fjpolo/SR-1_SoC/PremadePrograms/HandAssembled/README.txt

These files are old - I am writing an assembler to do the hard work for me.
It is very tedious to write programs by hand, so I do not recommend it!!
