fjpolo/SR-1_SoC/Testing/README.txt

Relevant files for testing purposes (placeholder for the Gowin IP cores, as I could not get their sim package to work)
