fjpolo/SR-1_SoC/GPU/VRAM/gowin_dpb/dp_bsram16v.v

//Copyright (C)2014-2024 Gowin Semiconductor Corporation.
//All rights reserved.
//File Title: IP file
//Tool Version: V1.9.10.03 Education (64-bit)
//Part Number: GW1NR-LV9QN88PC6/I5
//Device: GW1NR-9
//Device Version: C
//Created Time: Tue Feb 11 19:09:59 2025

module DP_BSRAM16V (douta, doutb, clka, ocea, cea, reseta, wrea, clkb, oceb, ceb, resetb, wreb, ada, dina, adb, dinb);

output [15:0] douta;
output [15:0] doutb;
input clka;
input ocea;
input cea;
input reseta;
input wrea;
input clkb;
input oceb;
input ceb;
input resetb;
input wreb;
input [12:0] ada;
input [15:0] dina;
input [12:0] adb;
input [15:0] dinb;

wire [11:0] dpb_inst_0_douta_w;
wire [3:0] dpb_inst_0_douta;
wire [11:0] dpb_inst_0_doutb_w;
wire [3:0] dpb_inst_0_doutb;
wire [11:0] dpb_inst_1_douta_w;
wire [7:4] dpb_inst_1_douta;
wire [11:0] dpb_inst_1_doutb_w;
wire [7:4] dpb_inst_1_doutb;
wire [7:0] dpb_inst_2_douta_w;
wire [7:0] dpb_inst_2_douta;
wire [7:0] dpb_inst_2_doutb_w;
wire [7:0] dpb_inst_2_doutb;
wire [11:0] dpb_inst_3_douta_w;
wire [11:8] dpb_inst_3_douta;
wire [11:0] dpb_inst_3_doutb_w;
wire [11:8] dpb_inst_3_doutb;
wire [11:0] dpb_inst_4_douta_w;
wire [15:12] dpb_inst_4_douta;
wire [11:0] dpb_inst_4_doutb_w;
wire [15:12] dpb_inst_4_doutb;
wire [7:0] dpb_inst_5_douta_w;
wire [15:8] dpb_inst_5_douta;
wire [7:0] dpb_inst_5_doutb_w;
wire [15:8] dpb_inst_5_doutb;
wire dff_q_0;
wire dff_q_1;
wire cea_w;
wire ceb_w;
wire gw_gnd;

assign cea_w = ~wrea & cea;
assign ceb_w = ~wreb & ceb;
assign gw_gnd = 1'b0;

DPB dpb_inst_0 (
    .DOA({dpb_inst_0_douta_w[11:0],dpb_inst_0_douta[3:0]}),
    .DOB({dpb_inst_0_doutb_w[11:0],dpb_inst_0_doutb[3:0]}),
    .CLKA(clka),
    .OCEA(ocea),
    .CEA(cea),
    .RESETA(reseta),
    .WREA(wrea),
    .CLKB(clkb),
    .OCEB(oceb),
    .CEB(ceb),
    .RESETB(resetb),
    .WREB(wreb),
    .BLKSELA({gw_gnd,gw_gnd,ada[12]}),
    .BLKSELB({gw_gnd,gw_gnd,adb[12]}),
    .ADA({ada[11:0],gw_gnd,gw_gnd}),
    .DIA({gw_gnd,gw_gnd,gw_gnd,gw_gnd,gw_gnd,gw_gnd,gw_gnd,gw_gnd,gw_gnd,gw_gnd,gw_gnd,gw_gnd,dina[3:0]}),
    .ADB({adb[11:0],gw_gnd,gw_gnd}),
    .DIB({gw_gnd,gw_gnd,gw_gnd,gw_gnd,gw_gnd,gw_gnd,gw_gnd,gw_gnd,gw_gnd,gw_gnd,gw_gnd,gw_gnd,dinb[3:0]})
);

defparam dpb_inst_0.READ_MODE0 = 1'b0;
defparam dpb_inst_0.READ_MODE1 = 1'b0;
defparam dpb_inst_0.WRITE_MODE0 = 2'b00;
defparam dpb_inst_0.WRITE_MODE1 = 2'b00;
defparam dpb_inst_0.BIT_WIDTH_0 = 4;
defparam dpb_inst_0.BIT_WIDTH_1 = 4;
defparam dpb_inst_0.BLK_SEL_0 = 3'b000;
defparam dpb_inst_0.BLK_SEL_1 = 3'b000;
defparam dpb_inst_0.RESET_MODE = "ASYNC";

DPB dpb_inst_1 (
    .DOA({dpb_inst_1_douta_w[11:0],dpb_inst_1_douta[7:4]}),
    .DOB({dpb_inst_1_doutb_w[11:0],dpb_inst_1_doutb[7:4]}),
    .CLKA(clka),
    .OCEA(ocea),
    .CEA(cea),
    .RESETA(reseta),
    .WREA(wrea),
    .CLKB(clkb),
    .OCEB(oceb),
    .CEB(ceb),
    .RESETB(resetb),
    .WREB(wreb),
    .BLKSELA({gw_gnd,gw_gnd,ada[12]}),
    .BLKSELB({gw_gnd,gw_gnd,adb[12]}),
    .ADA({ada[11:0],gw_gnd,gw_gnd}),
    .DIA({gw_gnd,gw_gnd,gw_gnd,gw_gnd,gw_gnd,gw_gnd,gw_gnd,gw_gnd,gw_gnd,gw_gnd,gw_gnd,gw_gnd,dina[7:4]}),
    .ADB({adb[11:0],gw_gnd,gw_gnd}),
    .DIB({gw_gnd,gw_gnd,gw_gnd,gw_gnd,gw_gnd,gw_gnd,gw_gnd,gw_gnd,gw_gnd,gw_gnd,gw_gnd,gw_gnd,dinb[7:4]})
);

defparam dpb_inst_1.READ_MODE0 = 1'b0;
defparam dpb_inst_1.READ_MODE1 = 1'b0;
defparam dpb_inst_1.WRITE_MODE0 = 2'b00;
defparam dpb_inst_1.WRITE_MODE1 = 2'b00;
defparam dpb_inst_1.BIT_WIDTH_0 = 4;
defparam dpb_inst_1.BIT_WIDTH_1 = 4;
defparam dpb_inst_1.BLK_SEL_0 = 3'b000;
defparam dpb_inst_1.BLK_SEL_1 = 3'b000;
defparam dpb_inst_1.RESET_MODE = "ASYNC";

DPB dpb_inst_2 (
    .DOA({dpb_inst_2_douta_w[7:0],dpb_inst_2_douta[7:0]}),
    .DOB({dpb_inst_2_doutb_w[7:0],dpb_inst_2_doutb[7:0]}),
    .CLKA(clka),
    .OCEA(ocea),
    .CEA(cea),
    .RESETA(reseta),
    .WREA(wrea),
    .CLKB(clkb),
    .OCEB(oceb),
    .CEB(ceb),
    .RESETB(resetb),
    .WREB(wreb),
    .BLKSELA({gw_gnd,ada[12],ada[11]}),
    .BLKSELB({gw_gnd,adb[12],adb[11]}),
    .ADA({ada[10:0],gw_gnd,gw_gnd,gw_gnd}),
    .DIA({gw_gnd,gw_gnd,gw_gnd,gw_gnd,gw_gnd,gw_gnd,gw_gnd,gw_gnd,dina[7:0]}),
    .ADB({adb[10:0],gw_gnd,gw_gnd,gw_gnd}),
    .DIB({gw_gnd,gw_gnd,gw_gnd,gw_gnd,gw_gnd,gw_gnd,gw_gnd,gw_gnd,dinb[7:0]})
);

defparam dpb_inst_2.READ_MODE0 = 1'b0;
defparam dpb_inst_2.READ_MODE1 = 1'b0;
defparam dpb_inst_2.WRITE_MODE0 = 2'b00;
defparam dpb_inst_2.WRITE_MODE1 = 2'b00;
defparam dpb_inst_2.BIT_WIDTH_0 = 8;
defparam dpb_inst_2.BIT_WIDTH_1 = 8;
defparam dpb_inst_2.BLK_SEL_0 = 3'b010;
defparam dpb_inst_2.BLK_SEL_1 = 3'b010;
defparam dpb_inst_2.RESET_MODE = "ASYNC";

DPB dpb_inst_3 (
    .DOA({dpb_inst_3_douta_w[11:0],dpb_inst_3_douta[11:8]}),
    .DOB({dpb_inst_3_doutb_w[11:0],dpb_inst_3_doutb[11:8]}),
    .CLKA(clka),
    .OCEA(ocea),
    .CEA(cea),
    .RESETA(reseta),
    .WREA(wrea),
    .CLKB(clkb),
    .OCEB(oceb),
    .CEB(ceb),
    .RESETB(resetb),
    .WREB(wreb),
    .BLKSELA({gw_gnd,gw_gnd,ada[12]}),
    .BLKSELB({gw_gnd,gw_gnd,adb[12]}),
    .ADA({ada[11:0],gw_gnd,gw_gnd}),
    .DIA({gw_gnd,gw_gnd,gw_gnd,gw_gnd,gw_gnd,gw_gnd,gw_gnd,gw_gnd,gw_gnd,gw_gnd,gw_gnd,gw_gnd,dina[11:8]}),
    .ADB({adb[11:0],gw_gnd,gw_gnd}),
    .DIB({gw_gnd,gw_gnd,gw_gnd,gw_gnd,gw_gnd,gw_gnd,gw_gnd,gw_gnd,gw_gnd,gw_gnd,gw_gnd,gw_gnd,dinb[11:8]})
);

defparam dpb_inst_3.READ_MODE0 = 1'b0;
defparam dpb_inst_3.READ_MODE1 = 1'b0;
defparam dpb_inst_3.WRITE_MODE0 = 2'b00;
defparam dpb_inst_3.WRITE_MODE1 = 2'b00;
defparam dpb_inst_3.BIT_WIDTH_0 = 4;
defparam dpb_inst_3.BIT_WIDTH_1 = 4;
defparam dpb_inst_3.BLK_SEL_0 = 3'b000;
defparam dpb_inst_3.BLK_SEL_1 = 3'b000;
defparam dpb_inst_3.RESET_MODE = "ASYNC";

DPB dpb_inst_4 (
    .DOA({dpb_inst_4_douta_w[11:0],dpb_inst_4_douta[15:12]}),
    .DOB({dpb_inst_4_doutb_w[11:0],dpb_inst_4_doutb[15:12]}),
    .CLKA(clka),
    .OCEA(ocea),
    .CEA(cea),
    .RESETA(reseta),
    .WREA(wrea),
    .CLKB(clkb),
    .OCEB(oceb),
    .CEB(ceb),
    .RESETB(resetb),
    .WREB(wreb),
    .BLKSELA({gw_gnd,gw_gnd,ada[12]}),
    .BLKSELB({gw_gnd,gw_gnd,adb[12]}),
    .ADA({ada[11:0],gw_gnd,gw_gnd}),
    .DIA({gw_gnd,gw_gnd,gw_gnd,gw_gnd,gw_gnd,gw_gnd,gw_gnd,gw_gnd,gw_gnd,gw_gnd,gw_gnd,gw_gnd,dina[15:12]}),
    .ADB({adb[11:0],gw_gnd,gw_gnd}),
    .DIB({gw_gnd,gw_gnd,gw_gnd,gw_gnd,gw_gnd,gw_gnd,gw_gnd,gw_gnd,gw_gnd,gw_gnd,gw_gnd,gw_gnd,dinb[15:12]})
);

defparam dpb_inst_4.READ_MODE0 = 1'b0;
defparam dpb_inst_4.READ_MODE1 = 1'b0;
defparam dpb_inst_4.WRITE_MODE0 = 2'b00;
defparam dpb_inst_4.WRITE_MODE1 = 2'b00;
defparam dpb_inst_4.BIT_WIDTH_0 = 4;
defparam dpb_inst_4.BIT_WIDTH_1 = 4;
defparam dpb_inst_4.BLK_SEL_0 = 3'b000;
defparam dpb_inst_4.BLK_SEL_1 = 3'b000;
defparam dpb_inst_4.RESET_MODE = "ASYNC";

DPB dpb_inst_5 (
    .DOA({dpb_inst_5_douta_w[7:0],dpb_inst_5_douta[15:8]}),
    .DOB({dpb_inst_5_doutb_w[7:0],dpb_inst_5_doutb[15:8]}),
    .CLKA(clka),
    .OCEA(ocea),
    .CEA(cea),
    .RESETA(reseta),
    .WREA(wrea),
    .CLKB(clkb),
    .OCEB(oceb),
    .CEB(ceb),
    .RESETB(resetb),
    .WREB(wreb),
    .BLKSELA({gw_gnd,ada[12],ada[11]}),
    .BLKSELB({gw_gnd,adb[12],adb[11]}),
    .ADA({ada[10:0],gw_gnd,gw_gnd,gw_gnd}),
    .DIA({gw_gnd,gw_gnd,gw_gnd,gw_gnd,gw_gnd,gw_gnd,gw_gnd,gw_gnd,dina[15:8]}),
    .ADB({adb[10:0],gw_gnd,gw_gnd,gw_gnd}),
    .DIB({gw_gnd,gw_gnd,gw_gnd,gw_gnd,gw_gnd,gw_gnd,gw_gnd,gw_gnd,dinb[15:8]})
);

defparam dpb_inst_5.READ_MODE0 = 1'b0;
defparam dpb_inst_5.READ_MODE1 = 1'b0;
defparam dpb_inst_5.WRITE_MODE0 = 2'b00;
defparam dpb_inst_5.WRITE_MODE1 = 2'b00;
defparam dpb_inst_5.BIT_WIDTH_0 = 8;
defparam dpb_inst_5.BIT_WIDTH_1 = 8;
defparam dpb_inst_5.BLK_SEL_0 = 3'b010;
defparam dpb_inst_5.BLK_SEL_1 = 3'b010;
defparam dpb_inst_5.RESET_MODE = "ASYNC";

DFFE dff_inst_0 (
  .Q(dff_q_0),
  .D(ada[12]),
  .CLK(clka),
  .CE(cea_w)
);
DFFE dff_inst_1 (
  .Q(dff_q_1),
  .D(adb[12]),
  .CLK(clkb),
  .CE(ceb_w)
);
MUX2 mux_inst_2 (
  .O(douta[0]),
  .I0(dpb_inst_0_douta[0]),
  .I1(dpb_inst_2_douta[0]),
  .S0(dff_q_0)
);
MUX2 mux_inst_5 (
  .O(douta[1]),
  .I0(dpb_inst_0_douta[1]),
  .I1(dpb_inst_2_douta[1]),
  .S0(dff_q_0)
);
MUX2 mux_inst_8 (
  .O(douta[2]),
  .I0(dpb_inst_0_douta[2]),
  .I1(dpb_inst_2_douta[2]),
  .S0(dff_q_0)
);
MUX2 mux_inst_11 (
  .O(douta[3]),
  .I0(dpb_inst_0_douta[3]),
  .I1(dpb_inst_2_douta[3]),
  .S0(dff_q_0)
);
MUX2 mux_inst_14 (
  .O(douta[4]),
  .I0(dpb_inst_1_douta[4]),
  .I1(dpb_inst_2_douta[4]),
  .S0(dff_q_0)
);
MUX2 mux_inst_17 (
  .O(douta[5]),
  .I0(dpb_inst_1_douta[5]),
  .I1(dpb_inst_2_douta[5]),
  .S0(dff_q_0)
);
MUX2 mux_inst_20 (
  .O(douta[6]),
  .I0(dpb_inst_1_douta[6]),
  .I1(dpb_inst_2_douta[6]),
  .S0(dff_q_0)
);
MUX2 mux_inst_23 (
  .O(douta[7]),
  .I0(dpb_inst_1_douta[7]),
  .I1(dpb_inst_2_douta[7]),
  .S0(dff_q_0)
);
MUX2 mux_inst_26 (
  .O(douta[8]),
  .I0(dpb_inst_3_douta[8]),
  .I1(dpb_inst_5_douta[8]),
  .S0(dff_q_0)
);
MUX2 mux_inst_29 (
  .O(douta[9]),
  .I0(dpb_inst_3_douta[9]),
  .I1(dpb_inst_5_douta[9]),
  .S0(dff_q_0)
);
MUX2 mux_inst_32 (
  .O(douta[10]),
  .I0(dpb_inst_3_douta[10]),
  .I1(dpb_inst_5_douta[10]),
  .S0(dff_q_0)
);
MUX2 mux_inst_35 (
  .O(douta[11]),
  .I0(dpb_inst_3_douta[11]),
  .I1(dpb_inst_5_douta[11]),
  .S0(dff_q_0)
);
MUX2 mux_inst_38 (
  .O(douta[12]),
  .I0(dpb_inst_4_douta[12]),
  .I1(dpb_inst_5_douta[12]),
  .S0(dff_q_0)
);
MUX2 mux_inst_41 (
  .O(douta[13]),
  .I0(dpb_inst_4_douta[13]),
  .I1(dpb_inst_5_douta[13]),
  .S0(dff_q_0)
);
MUX2 mux_inst_44 (
  .O(douta[14]),
  .I0(dpb_inst_4_douta[14]),
  .I1(dpb_inst_5_douta[14]),
  .S0(dff_q_0)
);
MUX2 mux_inst_47 (
  .O(douta[15]),
  .I0(dpb_inst_4_douta[15]),
  .I1(dpb_inst_5_douta[15]),
  .S0(dff_q_0)
);
MUX2 mux_inst_50 (
  .O(doutb[0]),
  .I0(dpb_inst_0_doutb[0]),
  .I1(dpb_inst_2_doutb[0]),
  .S0(dff_q_1)
);
MUX2 mux_inst_53 (
  .O(doutb[1]),
  .I0(dpb_inst_0_doutb[1]),
  .I1(dpb_inst_2_doutb[1]),
  .S0(dff_q_1)
);
MUX2 mux_inst_56 (
  .O(doutb[2]),
  .I0(dpb_inst_0_doutb[2]),
  .I1(dpb_inst_2_doutb[2]),
  .S0(dff_q_1)
);
MUX2 mux_inst_59 (
  .O(doutb[3]),
  .I0(dpb_inst_0_doutb[3]),
  .I1(dpb_inst_2_doutb[3]),
  .S0(dff_q_1)
);
MUX2 mux_inst_62 (
  .O(doutb[4]),
  .I0(dpb_inst_1_doutb[4]),
  .I1(dpb_inst_2_doutb[4]),
  .S0(dff_q_1)
);
MUX2 mux_inst_65 (
  .O(doutb[5]),
  .I0(dpb_inst_1_doutb[5]),
  .I1(dpb_inst_2_doutb[5]),
  .S0(dff_q_1)
);
MUX2 mux_inst_68 (
  .O(doutb[6]),
  .I0(dpb_inst_1_doutb[6]),
  .I1(dpb_inst_2_doutb[6]),
  .S0(dff_q_1)
);
MUX2 mux_inst_71 (
  .O(doutb[7]),
  .I0(dpb_inst_1_doutb[7]),
  .I1(dpb_inst_2_doutb[7]),
  .S0(dff_q_1)
);
MUX2 mux_inst_74 (
  .O(doutb[8]),
  .I0(dpb_inst_3_doutb[8]),
  .I1(dpb_inst_5_doutb[8]),
  .S0(dff_q_1)
);
MUX2 mux_inst_77 (
  .O(doutb[9]),
  .I0(dpb_inst_3_doutb[9]),
  .I1(dpb_inst_5_doutb[9]),
  .S0(dff_q_1)
);
MUX2 mux_inst_80 (
  .O(doutb[10]),
  .I0(dpb_inst_3_doutb[10]),
  .I1(dpb_inst_5_doutb[10]),
  .S0(dff_q_1)
);
MUX2 mux_inst_83 (
  .O(doutb[11]),
  .I0(dpb_inst_3_doutb[11]),
  .I1(dpb_inst_5_doutb[11]),
  .S0(dff_q_1)
);
MUX2 mux_inst_86 (
  .O(doutb[12]),
  .I0(dpb_inst_4_doutb[12]),
  .I1(dpb_inst_5_doutb[12]),
  .S0(dff_q_1)
);
MUX2 mux_inst_89 (
  .O(doutb[13]),
  .I0(dpb_inst_4_doutb[13]),
  .I1(dpb_inst_5_doutb[13]),
  .S0(dff_q_1)
);
MUX2 mux_inst_92 (
  .O(doutb[14]),
  .I0(dpb_inst_4_doutb[14]),
  .I1(dpb_inst_5_doutb[14]),
  .S0(dff_q_1)
);
MUX2 mux_inst_95 (
  .O(doutb[15]),
  .I0(dpb_inst_4_doutb[15]),
  .I1(dpb_inst_5_doutb[15]),
  .S0(dff_q_1)
);
endmodule //DP_BSRAM16V
