fjpolo/SR-1_SoC/CPU/Memory/v1/gowin_sp/bsram.v

//Copyright (C)2014-2024 Gowin Semiconductor Corporation.
//All rights reserved.
//File Title: IP file
//Tool Version: V1.9.10.03 Education (64-bit)
//Part Number: GW1NR-LV9QN88PC6/I5
//Device: GW1NR-9
//Device Version: C
//Created Time: Tue Jan 21 01:02:18 2025

module BSRAM (dout, clk, oce, ce, reset, wre, ad, din);

output [7:0] dout;
input clk;
input oce;
input ce;
input reset;
input wre;
input [14:0] ad;
input [7:0] din;

wire [30:0] sp_inst_0_dout_w;
wire [0:0] sp_inst_0_dout;
wire [30:0] sp_inst_1_dout_w;
wire [0:0] sp_inst_1_dout;
wire [30:0] sp_inst_2_dout_w;
wire [1:1] sp_inst_2_dout;
wire [30:0] sp_inst_3_dout_w;
wire [1:1] sp_inst_3_dout;
wire [30:0] sp_inst_4_dout_w;
wire [2:2] sp_inst_4_dout;
wire [30:0] sp_inst_5_dout_w;
wire [2:2] sp_inst_5_dout;
wire [30:0] sp_inst_6_dout_w;
wire [3:3] sp_inst_6_dout;
wire [30:0] sp_inst_7_dout_w;
wire [3:3] sp_inst_7_dout;
wire [30:0] sp_inst_8_dout_w;
wire [4:4] sp_inst_8_dout;
wire [30:0] sp_inst_9_dout_w;
wire [4:4] sp_inst_9_dout;
wire [30:0] sp_inst_10_dout_w;
wire [5:5] sp_inst_10_dout;
wire [30:0] sp_inst_11_dout_w;
wire [5:5] sp_inst_11_dout;
wire [30:0] sp_inst_12_dout_w;
wire [6:6] sp_inst_12_dout;
wire [30:0] sp_inst_13_dout_w;
wire [6:6] sp_inst_13_dout;
wire [30:0] sp_inst_14_dout_w;
wire [7:7] sp_inst_14_dout;
wire [30:0] sp_inst_15_dout_w;
wire [7:7] sp_inst_15_dout;
wire dff_q_0;
wire ce_w;
wire gw_gnd;

assign ce_w = ~wre & ce;
assign gw_gnd = 1'b0;

SP sp_inst_0 (
    .DO({sp_inst_0_dout_w[30:0],sp_inst_0_dout[0]}),
    .CLK(clk),
    .OCE(oce),
    .CE(ce),
    .RESET(reset),
    .WRE(wre),
    .BLKSEL({gw_gnd,gw_gnd,ad[14]}),
    .AD(ad[13:0]),
    .DI({gw_gnd,gw_gnd,gw_gnd,gw_gnd,gw_gnd,gw_gnd,gw_gnd,gw_gnd,gw_gnd,gw_gnd,gw_gnd,gw_gnd,gw_gnd,gw_gnd,gw_gnd,gw_gnd,gw_gnd,gw_gnd,gw_gnd,gw_gnd,gw_gnd,gw_gnd,gw_gnd,gw_gnd,gw_gnd,gw_gnd,gw_gnd,gw_gnd,gw_gnd,gw_gnd,gw_gnd,din[0]})
);

defparam sp_inst_0.READ_MODE = 1'b0;
defparam sp_inst_0.WRITE_MODE = 2'b00;
defparam sp_inst_0.BIT_WIDTH = 1;
defparam sp_inst_0.BLK_SEL = 3'b000;
defparam sp_inst_0.RESET_MODE = "ASYNC";

SP sp_inst_1 (
    .DO({sp_inst_1_dout_w[30:0],sp_inst_1_dout[0]}),
    .CLK(clk),
    .OCE(oce),
    .CE(ce),
    .RESET(reset),
    .WRE(wre),
    .BLKSEL({gw_gnd,gw_gnd,ad[14]}),
    .AD(ad[13:0]),
    .DI({gw_gnd,gw_gnd,gw_gnd,gw_gnd,gw_gnd,gw_gnd,gw_gnd,gw_gnd,gw_gnd,gw_gnd,gw_gnd,gw_gnd,gw_gnd,gw_gnd,gw_gnd,gw_gnd,gw_gnd,gw_gnd,gw_gnd,gw_gnd,gw_gnd,gw_gnd,gw_gnd,gw_gnd,gw_gnd,gw_gnd,gw_gnd,gw_gnd,gw_gnd,gw_gnd,gw_gnd,din[0]})
);

defparam sp_inst_1.READ_MODE = 1'b0;
defparam sp_inst_1.WRITE_MODE = 2'b00;
defparam sp_inst_1.BIT_WIDTH = 1;
defparam sp_inst_1.BLK_SEL = 3'b001;
defparam sp_inst_1.RESET_MODE = "ASYNC";

SP sp_inst_2 (
    .DO({sp_inst_2_dout_w[30:0],sp_inst_2_dout[1]}),
    .CLK(clk),
    .OCE(oce),
    .CE(ce),
    .RESET(reset),
    .WRE(wre),
    .BLKSEL({gw_gnd,gw_gnd,ad[14]}),
    .AD(ad[13:0]),
    .DI({gw_gnd,gw_gnd,gw_gnd,gw_gnd,gw_gnd,gw_gnd,gw_gnd,gw_gnd,gw_gnd,gw_gnd,gw_gnd,gw_gnd,gw_gnd,gw_gnd,gw_gnd,gw_gnd,gw_gnd,gw_gnd,gw_gnd,gw_gnd,gw_gnd,gw_gnd,gw_gnd,gw_gnd,gw_gnd,gw_gnd,gw_gnd,gw_gnd,gw_gnd,gw_gnd,gw_gnd,din[1]})
);

defparam sp_inst_2.READ_MODE = 1'b0;
defparam sp_inst_2.WRITE_MODE = 2'b00;
defparam sp_inst_2.BIT_WIDTH = 1;
defparam sp_inst_2.BLK_SEL = 3'b000;
defparam sp_inst_2.RESET_MODE = "ASYNC";

SP sp_inst_3 (
    .DO({sp_inst_3_dout_w[30:0],sp_inst_3_dout[1]}),
    .CLK(clk),
    .OCE(oce),
    .CE(ce),
    .RESET(reset),
    .WRE(wre),
    .BLKSEL({gw_gnd,gw_gnd,ad[14]}),
    .AD(ad[13:0]),
    .DI({gw_gnd,gw_gnd,gw_gnd,gw_gnd,gw_gnd,gw_gnd,gw_gnd,gw_gnd,gw_gnd,gw_gnd,gw_gnd,gw_gnd,gw_gnd,gw_gnd,gw_gnd,gw_gnd,gw_gnd,gw_gnd,gw_gnd,gw_gnd,gw_gnd,gw_gnd,gw_gnd,gw_gnd,gw_gnd,gw_gnd,gw_gnd,gw_gnd,gw_gnd,gw_gnd,gw_gnd,din[1]})
);

defparam sp_inst_3.READ_MODE = 1'b0;
defparam sp_inst_3.WRITE_MODE = 2'b00;
defparam sp_inst_3.BIT_WIDTH = 1;
defparam sp_inst_3.BLK_SEL = 3'b001;
defparam sp_inst_3.RESET_MODE = "ASYNC";

SP sp_inst_4 (
    .DO({sp_inst_4_dout_w[30:0],sp_inst_4_dout[2]}),
    .CLK(clk),
    .OCE(oce),
    .CE(ce),
    .RESET(reset),
    .WRE(wre),
    .BLKSEL({gw_gnd,gw_gnd,ad[14]}),
    .AD(ad[13:0]),
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
  .I1(sp_inst_11_dout[5]),
  .S0(dff_q_0)
);
MUX2 mux_inst_6 (
  .O(dout[6]),
  .I0(sp_inst_12_dout[6]),
  .I1(sp_inst_13_dout[6]),
  .S0(dff_q_0)
);
MUX2 mux_inst_7 (
  .O(dout[7]),
  .I0(sp_inst_14_dout[7]),
  .I1(sp_inst_15_dout[7]),
  .S0(dff_q_0)
);
endmodule //BSRAM
