fjpolo/SR-1_SoC/GPU/FloatingPoint/FP_FP2int/TB.sv

module FP_FP2int_TB;

	logic [15:0] integer_num;
	logic [15:0] fp_num, out;
	
	FP_Int2fp i0 (.*);
	
	FP_FP2int fp0 (.fp_num(fp_num), .integer_num(out));
	
	initial
	begin
		integer_num = 16'd12343;
		#10ns;
		integer_num = 16'd18343;
		#10ns;
		integer_num = 16'd32343;
		#10ns;
		integer_num = 16'd17;
		#10ns;
		integer_num = 16'd256;
		#10ns;
		integer_num = 16'd1;
		#10ns;
		integer_num = 16'd65535;
		#10ns;
	end
endmodule
