fjpolo/SR-1_SoC/GPU/FloatingPoint/FP_FP2int/gowin_rom16/rom16_fp2i_tmp.v

//Copyright (C)2014-2024 Gowin Semiconductor Corporation.
//All rights reserved.
//File Title: Template file for instantiation
//Tool Version: V1.9.10.03 Education (64-bit)
//Part Number: GW1NR-LV9QN88PC6/I5
//Device: GW1NR-9
//Device Version: C
//Created Time: Wed Feb 12 23:33:22 2025

//Change the instance name and port connections to the signal names
//--------Copy here to design--------

    ROM16_FP2I your_instance_name(
        .dout(dout), //output [15:0] dout
        .ad(ad) //input [3:0] ad
    );

//--------Copy end-------------------
