fjpolo/SR-1_SoC/CPU/ClockPrescaler/gowin_rom16/rom16_clk.v

//Copyright (C)2014-2024 Gowin Semiconductor Corporation.
//All rights reserved.
//File Title: IP file
//Tool Version: V1.9.10.03 Education (64-bit)
//Part Number: GW1NR-LV9QN88PC6/I5
//Device: GW1NR-9
//Device Version: C
//Created Time: Thu Feb 20 21:23:13 2025

module ROM16_CLK (dout, ad);

output [23:0] dout;
input [3:0] ad;

ROM16 rom16_inst_0 (
    .DO(dout[0]),
    .AD(ad[3:0])
);

defparam rom16_inst_0.INIT_0 = 16'hFD64;

ROM16 rom16_inst_1 (
    .DO(dout[1]),
    .AD(ad[3:0])
);

defparam rom16_inst_1.INIT_0 = 16'hFB00;

ROM16 rom16_inst_2 (
    .DO(dout[2]),
    .AD(ad[3:0])
);

defparam rom16_inst_2.INIT_0 = 16'hF6C8;

ROM16 rom16_inst_3 (
    .DO(dout[3]),
    .AD(ad[3:0])
);

defparam rom16_inst_3.INIT_0 = 16'hE9D0;

ROM16 rom16_inst_4 (
    .DO(dout[4]),
    .AD(ad[3:0])
);

defparam rom16_inst_4.INIT_0 = 16'h9960;

ROM16 rom16_inst_5 (
    .DO(dout[5]),
    .AD(ad[3:0])
);

defparam rom16_inst_5.INIT_0 = 16'h6980;

ROM16 rom16_inst_6 (
    .DO(dout[6]),
    .AD(ad[3:0])
);

defparam rom16_inst_6.INIT_0 = 16'hB400;

ROM16 rom16_inst_7 (
    .DO(dout[7]),
    .AD(ad[3:0])
);

defparam rom16_inst_7.INIT_0 = 16'h0A00;

ROM16 rom16_inst_8 (
    .DO(dout[8]),
    .AD(ad[3:0])
);

defparam rom16_inst_8.INIT_0 = 16'h7400;

ROM16 rom16_inst_9 (
    .DO(dout[9]),
    .AD(ad[3:0])
);

defparam rom16_inst_9.INIT_0 = 16'hD000;

ROM16 rom16_inst_10 (
    .DO(dout[10]),
    .AD(ad[3:0])
);

defparam rom16_inst_10.INIT_0 = 16'hDC00;

ROM16 rom16_inst_11 (
    .DO(dout[11]),
    .AD(ad[3:0])
);

defparam rom16_inst_11.INIT_0 = 16'hF000;

ROM16 rom16_inst_12 (
    .DO(dout[12]),
    .AD(ad[3:0])
);

defparam rom16_inst_12.INIT_0 = 16'hE800;

ROM16 rom16_inst_13 (
    .DO(dout[13]),
    .AD(ad[3:0])
);

defparam rom16_inst_13.INIT_0 = 16'hC800;

ROM16 rom16_inst_14 (
    .DO(dout[14]),
    .AD(ad[3:0])
);

defparam rom16_inst_14.INIT_0 = 16'hC000;

ROM16 rom16_inst_15 (
    .DO(dout[15]),
    .AD(ad[3:0])
);

defparam rom16_inst_15.INIT_0 = 16'hE000;

ROM16 rom16_inst_16 (
    .DO(dout[16]),
    .AD(ad[3:0])
);

defparam rom16_inst_16.INIT_0 = 16'h8000;

ROM16 rom16_inst_17 (
    .DO(dout[17]),
    .AD(ad[3:0])
);

defparam rom16_inst_17.INIT_0 = 16'h5000;

ROM16 rom16_inst_18 (
    .DO(dout[18]),
    .AD(ad[3:0])
);

defparam rom16_inst_18.INIT_0 = 16'hE000;

ROM16 rom16_inst_19 (
    .DO(dout[19]),
    .AD(ad[3:0])
);

defparam rom16_inst_19.INIT_0 = 16'h8000;

ROM16 rom16_inst_20 (
    .DO(dout[20]),
    .AD(ad[3:0])
);

defparam rom16_inst_20.INIT_0 = 16'h2000;

ROM16 rom16_inst_21 (
    .DO(dout[21]),
    .AD(ad[3:0])
);

defparam rom16_inst_21.INIT_0 = 16'h4000;

ROM16 rom16_inst_22 (
    .DO(dout[22]),
    .AD(ad[3:0])
);

defparam rom16_inst_22.INIT_0 = 16'hC000;

ROM16 rom16_inst_23 (
    .DO(dout[23]),
    .AD(ad[3:0])
);

defparam rom16_inst_23.INIT_0 = 16'h8000;

endmodule //ROM16_CLK
