fjpolo/SR-1_SoC/(commit log)

2025-03-09 Fixed CPY and CPY2 bug
    Fixed issue where these two opcodes would not increment the PC properly and would not correctly transfer data
    [Opcodes.sv]
2025-03-09 Added Assembler and examples
    Added PONG! as well as a python based assembler for the SoC
2025-03-11 Changes for arrival of v2 Assembler
    Moved some folders around, and made the process of finding programs a little easier. Also added readme to premade programs file to explain each folder
2025-03-12 Added v2 Assembler
    Also added pong v2 (actually playable without burning your eyes now)
2025-03-14 Added Breakout
    Added a version of breakout, both pre-assembled and the raw assembly
2025-03-14 Added Warning to assembler
    Will warn if numeric argument given to a non immediate or GPU operation
2025-03-15 V2.0.1 Assembler update
    Added 0-initialised buffers that can take any width via the BUF keyword
2025-03-16 Added Register Memory Mapping
    Added register memory mapping and fixed programOffset bug in the assembler.
    [CPU16.sv, RAM.sv]
2025-03-17 Tiny Assembler update
    Moved the file opening for writing into the last section of the program so a failure to assemble does not wipe the old .mi file.
2025-03-18 Fixed ALU bug
    Forgot to add the multiplier output carry
    [ALU.sv]
2025-03-18 Fixed Multiplier Carry Bug
    Actually fixed the bug this time!
    [ALU.sv]
2025-03-22 Added Assembler Documentation
    Finally finished the documentation for the assembler! Now it should be much easier for people to understand it.
    Also rewrote the readme
2025-03-25 Added 8th Button, Removed SDA_IN
    SDA_IN not needed for I2C to function (as display is write only) so it has been removed to save a pin. In the future if needed, the existing SDA_OUT pin can be reconfig'ed into an inout pin anyway. Added the chassis button S2 as the 8th button. Will add to docs in later update
2025-03-27 Swapped P0 and P1
    Makes more sense in this orientation
    [CPU16.sv]
2025-03-28 Added Opcode Config File
    Much easier and more intuitive to add to or change the systems instruction set in the assembler. Added the a .acf file (assembler config file) with the current opcodes. Will explain how it is structured in documentation update later. Changes in readme to reflect file structure change
2025-03-28 Expanded Config File System
    Now the assembler supports multiple config versions in the same folder. It defaults to the most recent version, but a specific version can be targeted with the new -v tag. Used like so: -v1.0.0 for example
2025-03-31 Updated Assembler For CPU v1.1.0
    Also added a relevant new program, sevenSeg. This uses the new IO ports (A and B, both 8 bits) Reassembled old programs as some pre-def variables had their addresses changed
2025-03-31 Updated pins for CPU v1.1.0
    Added ports, removed thin switch and debug output (will be added back in later update adding different outputs for each port)
2025-04-03 Added GOWIN FPGA project
    Included the entire project file. Make sure to change the root file location in the .gprj file (open it in a text editor)
    [device.cfg]
